DNZioo/Student_Project/(list of files, drawings)

Other design files:
Proteus/opto_transi.pdsprj
Proteus/Project Backups/opto_transi [20241220, 18-22-56].pdsprj
Proteus/Project Backups/opto_transi [20241220, 18-27-27].pdsprj
Proteus/Project Backups/opto_transi [20241223, 23-27-32].pdsprj
Proteus/Project Backups/opto_transi [20241225, 17-43-28].pdsprj
Proteus/Project Backups/opto_transi [20241228, 16-23-40].pdsprj
Proteus/Project Backups/opto_transi [20250120, 23-39-29].pdsprj
Proteus/Project Backups/opto_transi [20250121, 11-37-40].pdsprj
Proteus/Project Backups/opto_transi [20250122, 00-04-37].pdsprj
Proteus/Project Backups/opto_transi [20250206, 10-13-02].pdsprj
Proteus/Project Backups/opto_transi [20250207, 17-20-12].pdsprj
