DNZioo/Student_Project/Kicad/IOT_development_board/IOT_development_board.kicad_pcb

## KiCad design Kicad/IOT_development_board/IOT_development_board.kicad_pcb (2025-03-19)

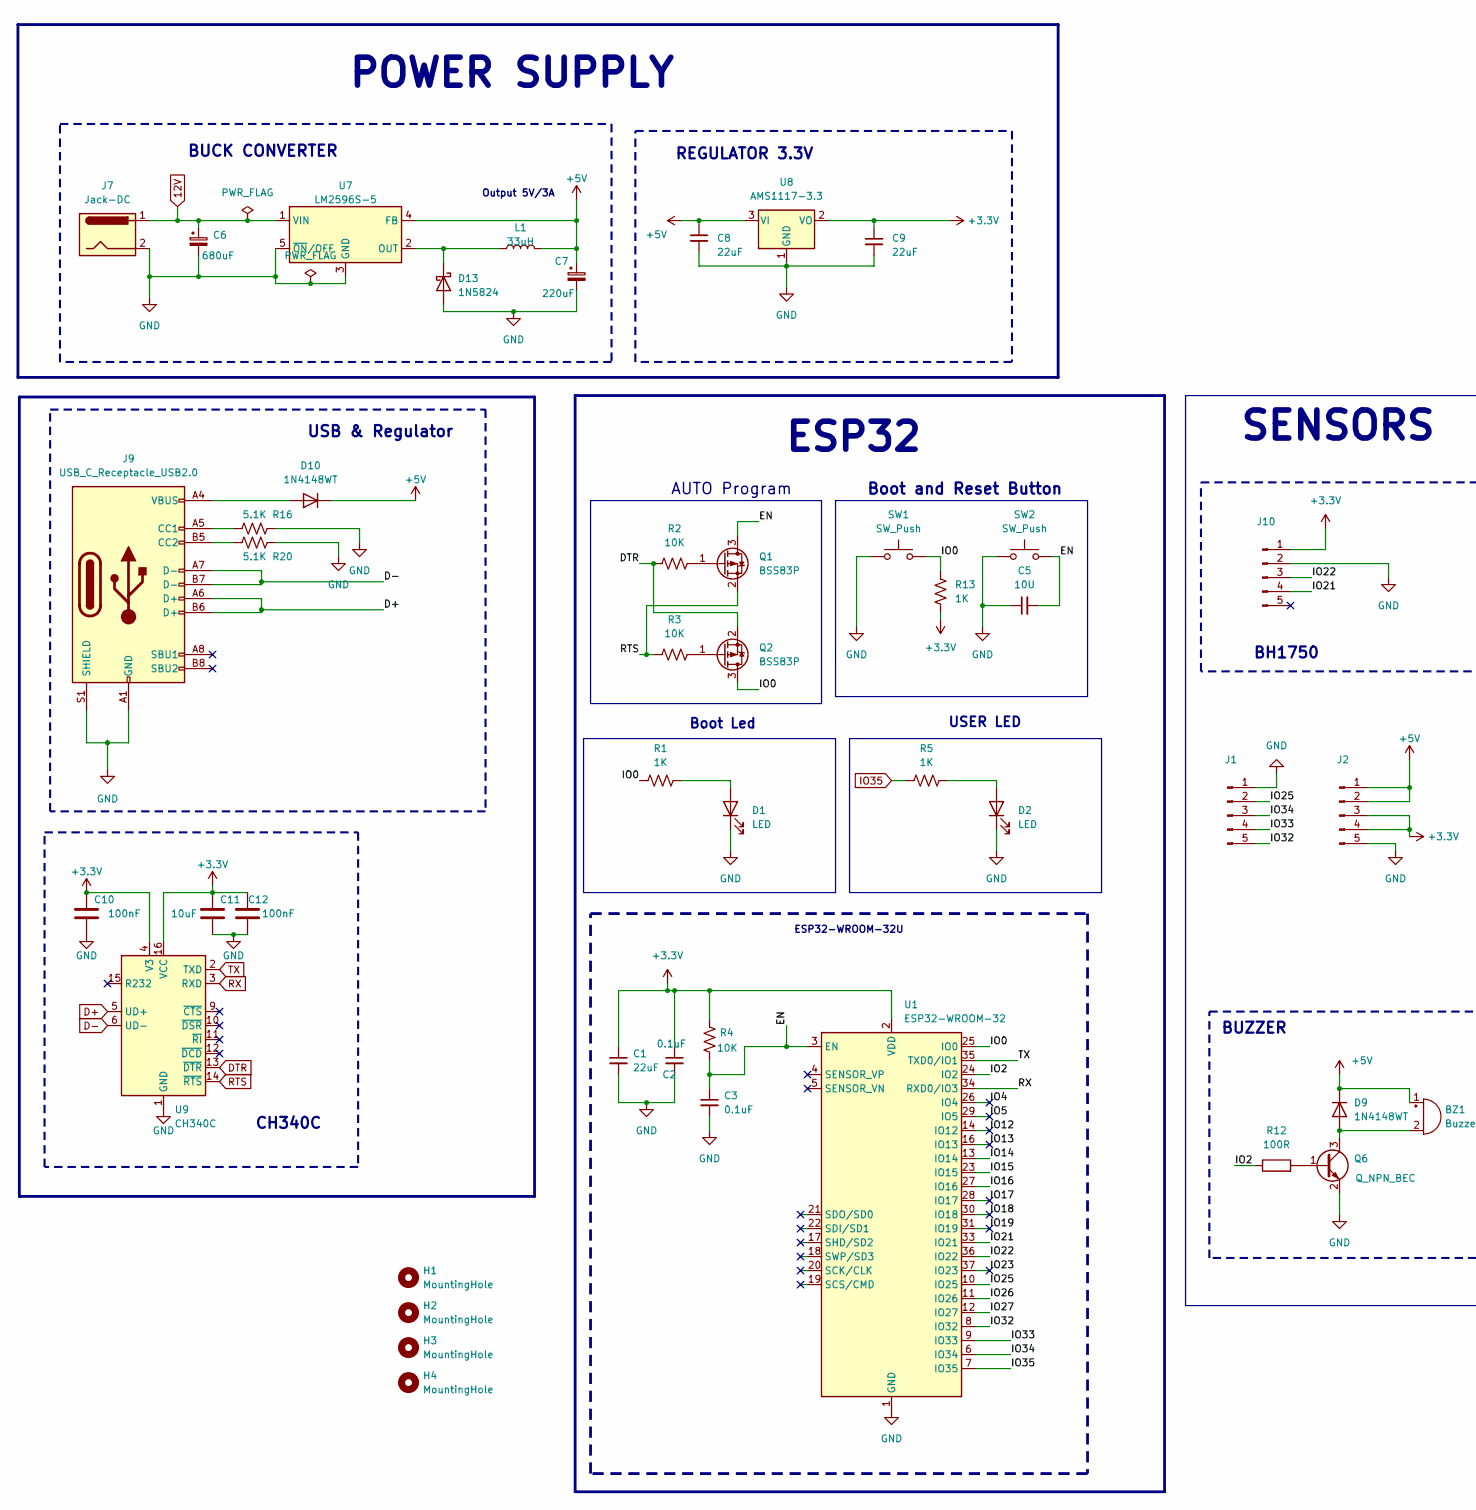
[picture p64: schematic IOT_development_board.kicad_sch, part in row 1, column 1]

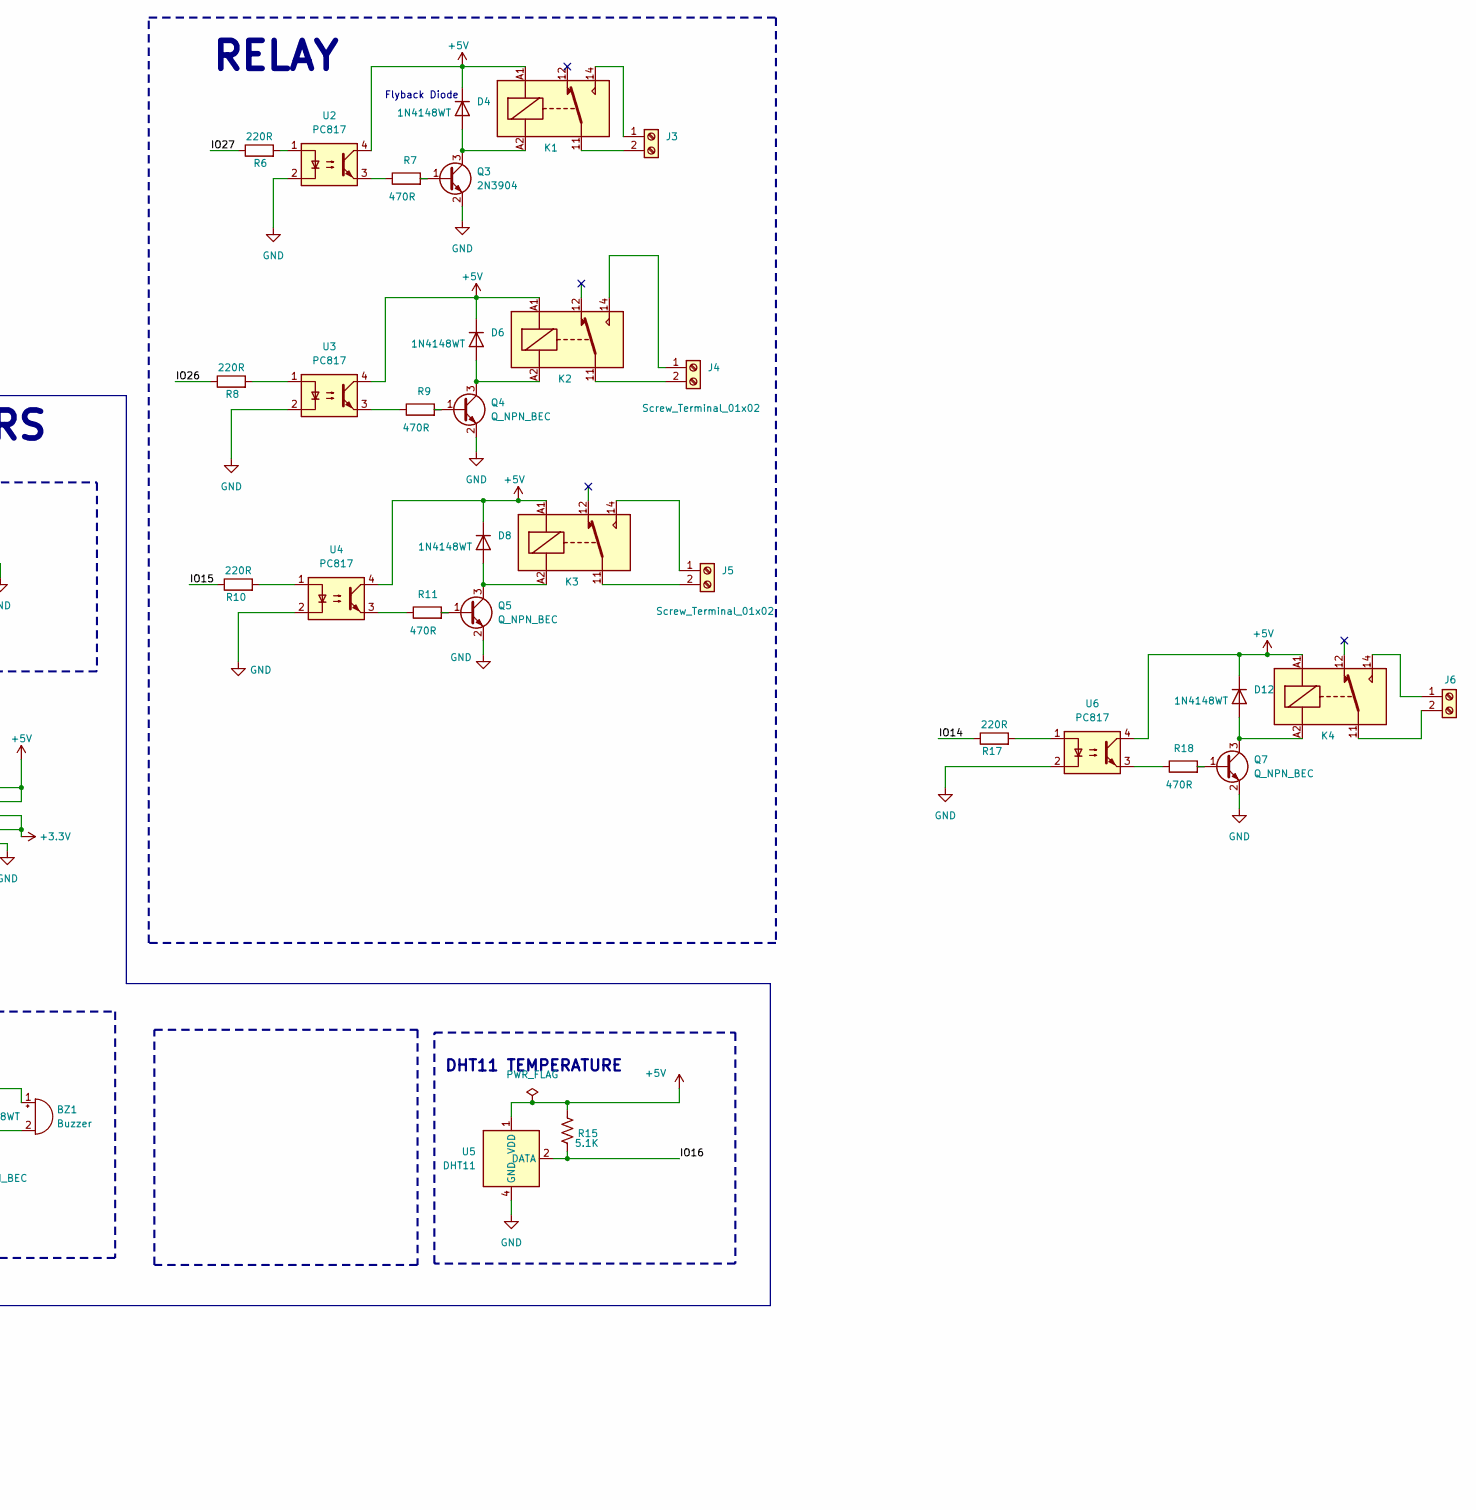
[picture p65: schematic IOT_development_board.kicad_sch, part in row 1, column 2]

Parts:
BZ1: Buzzer; Buzzer_TDK_PS1240P02BT_D12.2mm_H6.5mm
C1, C8, C9: 22uF; C_0603_1608Metric
C2, C3: 0.1uF; C_0603_1608Metric
C5: 10U; C_0603_1608Metric
C6: 680uF; CP_Elec_6.3x9.9
C7: 220uF; CP_Elec_6.3x9.9
C10, C12: 100nF; C_0603_1608Metric
C11: 10uF; C_0603_1608Metric
D1, D2: LED; LED_0603_1608Metric
D4, D6, D8, D12: 1N4148WT; D_SOD-523
D9, D10: 1N4148WT; D_SOD-123
D13: 1N5824; D_SOD-128
H1, H2, H3, H4: MountingHole; MountingHole_3.2mm_M3_Pad_Via
J1, J2, J10: Conn_01x05_Pin; PinHeader_1x05_P2.54mm_Vertical
J3, J4, J5, J6: Screw_Terminal_01x02; TerminalBlock_Phoenix_MKDS-1,5-2-5.08_1x02_P5.08mm_Horizont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
J7: Jack-DC; BarrelJack_Horizontal
J9: USB_C_Receptacle_USB2.0; USB_C_Receptacle_HRO_TYPE-C-31-M-12
K1, K2, K3, K4: Fujitsu_FTR-LYCA005x; Relay_SPDT_SANYOU_SRD_Series_Form_C_1
L1: 33uH; L_7.3x7.3_H3.5
Q1, Q2: BSS83P; SOT-23
Q3: 2N3904; SOT-23-3
Q4, Q5, Q6, Q7: Q_NPN_BEC; SOT-23-3
R1, R5, R13: 1K; R_0603_1608Metric
R2, R3, R4: 10K; R_0603_1608Metric
R6, R8, R10, R17: 220R; R_0603_1608Metric
R7, R9, R11, R18: 470R; R_0603_1608Metric
R12: 100R; R_0603_1608Metric
R15, R16, R20: 5.1K; R_0603_1608Metric
SW1, SW2: SW_Push; SW_SPST_B3U-1000P
U1: ESP32-WROOM-32
U2, U3, U4, U6: PC817
U5: DHT11; Aosong_DHT11_5.5x12.0_P2.54mm
U7: LM2596S-5; TO-263-5_TabPin3
U8: AMS1117-3.3; SOT-89-3
U9: CH340C; SOIC-16_3.9x9.9mm_P1.27mm

Connections:
12V: C6.1, J7.1, U7.1 (VIN)
+3.3V: C1.1, C2.1, C9.1, C10.1, C11.1, C12.1, J2.3, J2.4, J10.1, R4.1, R13.1, U1.2 (VDD), U8.2 (VO), U9.4 (V3), U9.16 (VCC); also elsewhere on the board
+5V: BZ1.1 (+), C7.1, C8.1, D4.1 (K), D6.1 (K), D8.1 (K), D9.1 (K), D10.1 (K), D12.1 (K), J2.1, J2.2, K1.A1, K2.A1, K3.A1, K4.A1, L1.2, R15.1, U2.4, U3.4, U4.4, U5.1 (VDD), U6.4, U7.4 (FB), U8.3 (VI)
/EN: C3.1, C5.2, Q1.3 (D), R4.2, SW2.2, U1.3 (EN)
/IO0: Q2.3 (D), R1.1, R13.2, SW1.2, U1.25 (IO0)
/IO2: R12.1, U1.24 (IO2)
/IO4: U1.26 (IO4)
/IO5: U1.29 (IO5)
/IO12: U1.14 (IO12)
/IO13: U1.16 (IO13)
/IO14: R17.1, U1.13 (IO14)
/IO15: R10.1, U1.23 (IO15)
/IO16: R15.2, U1.27 (IO16), U5.2 (DATA)
/IO17: U1.28 (IO17)
/IO18: U1.30 (IO18)
/IO19: U1.31 (IO19)
/IO21: J10.4, U1.33 (IO21)
/IO22: J10.3, U1.36 (IO22)
/IO23: U1.37 (IO23)
/IO25: J1.2, U1.10 (IO25)
/IO26: R8.1, U1.11 (IO26)
/IO27: R6.1, U1.12 (IO27)
/IO32: J1.5, U1.8 (IO32)
/IO33: J1.4, U1.9 (IO33)
/IO34: J1.3, U1.6 (IO34)
D+: J9.A6 (D+), J9.B6 (D+), U9.5 (UD+)
D-: J9.A7 (D-), J9.B7 (D-), U9.6 (UD-)
DTR: Q2.2 (S), R2.1, U9.13 (~DTR)
GND: C1.2, C2.2, C3.2, C5.1, C6.2, C7.2, C8.2, C9.2, C10.2, C11.2, C12.2, D1.1 (K), D2.1 (K), D13.2 (A), J1.1, J2.5, J7.2, J9.A1 (GND), J9.A12 (GND), J9.B1 (GND), J9.B12 (GND), J9.S1 (SHIELD), J10.2, Q3.2 (E), Q4.2 (E), Q5.2 (E), Q6.2 (E), Q7.2 (E), R16.2, R20.2, SW1.1, SW2.1, U1.1 (GND), U1.15 (GND), U1.38 (GND), U1.39 (GND), U2.2, U3.2, U4.2, U5.4 (GND), U6.2, U7.3 (GND), U7.5 (~ON/OFF), U8.1 (GND), U9.1 (GND); also elsewhere on the board
IO35: R5.1, U1.7 (IO35)
unnamed: BZ1.2 (-), D9.2 (A), Q6.3 (C)
unnamed: D1.2 (A), R1.2
unnamed: D2.2 (A), R5.2
unnamed: D4.2 (A), K1.A2, Q3.3 (C)
unnamed: D6.2 (A), K2.A2, Q4.3 (C)
unnamed: D8.2 (A), K3.A2, Q5.3 (C)
unnamed: D10.2 (A), J9.A4 (VBUS), J9.A9 (VBUS), J9.B4 (VBUS), J9.B9 (VBUS)
unnamed: D12.2 (A), K4.A2, Q7.3 (C)
unnamed: D13.1 (K), L1.1, U7.2 (OUT)
unnamed: J3.1, K1.14
unnamed: J3.2, K1.11
unnamed: J4.1, K2.14
unnamed: J4.2, K2.11
unnamed: J5.1, K3.14
unnamed: J5.2, K3.11
unnamed: J6.1, K4.14
unnamed: J6.2, K4.11
unnamed: J9.A5 (CC1), R16.1
unnamed: J9.B5 (CC2), R20.1
unnamed: Q1.1 (G), R2.2
unnamed: Q2.1 (G), R3.2
unnamed: Q3.1 (B), R7.2
unnamed: Q4.1 (B), R9.2
unnamed: Q5.1 (B), R11.2
unnamed: Q6.1 (B), R12.2
unnamed: Q7.1 (B), R18.2
unnamed: R6.2, U2.1
unnamed: R7.1, U2.3
unnamed: R8.2, U3.1
unnamed: R9.1, U3.3
unnamed: R10.2, U4.1
unnamed: R11.1, U4.3
unnamed: R17.2, U6.1
unnamed: R18.1, U6.3
RTS: Q1.2 (S), R3.1, U9.14 (~RTS)
RX: U1.34 (RXD0/IO3), U9.3 (RXD)
TX: U1.35 (TXD0/IO1), U9.2 (TXD)

Notes on the sheet:
Flyback Diode
Boot and Reset Button
Output 5V/3A
BUCK CONVERTER
USB & Regulator
ESP32-WROOM-32U
RELAY
CH340C
DHT11 TEMPERATURE
AUTO Program
POWER SUPPLY
REGULATOR 3.3V
Boot Led
ESP32
BH1750
BUZZER
SENSORS
USER LED

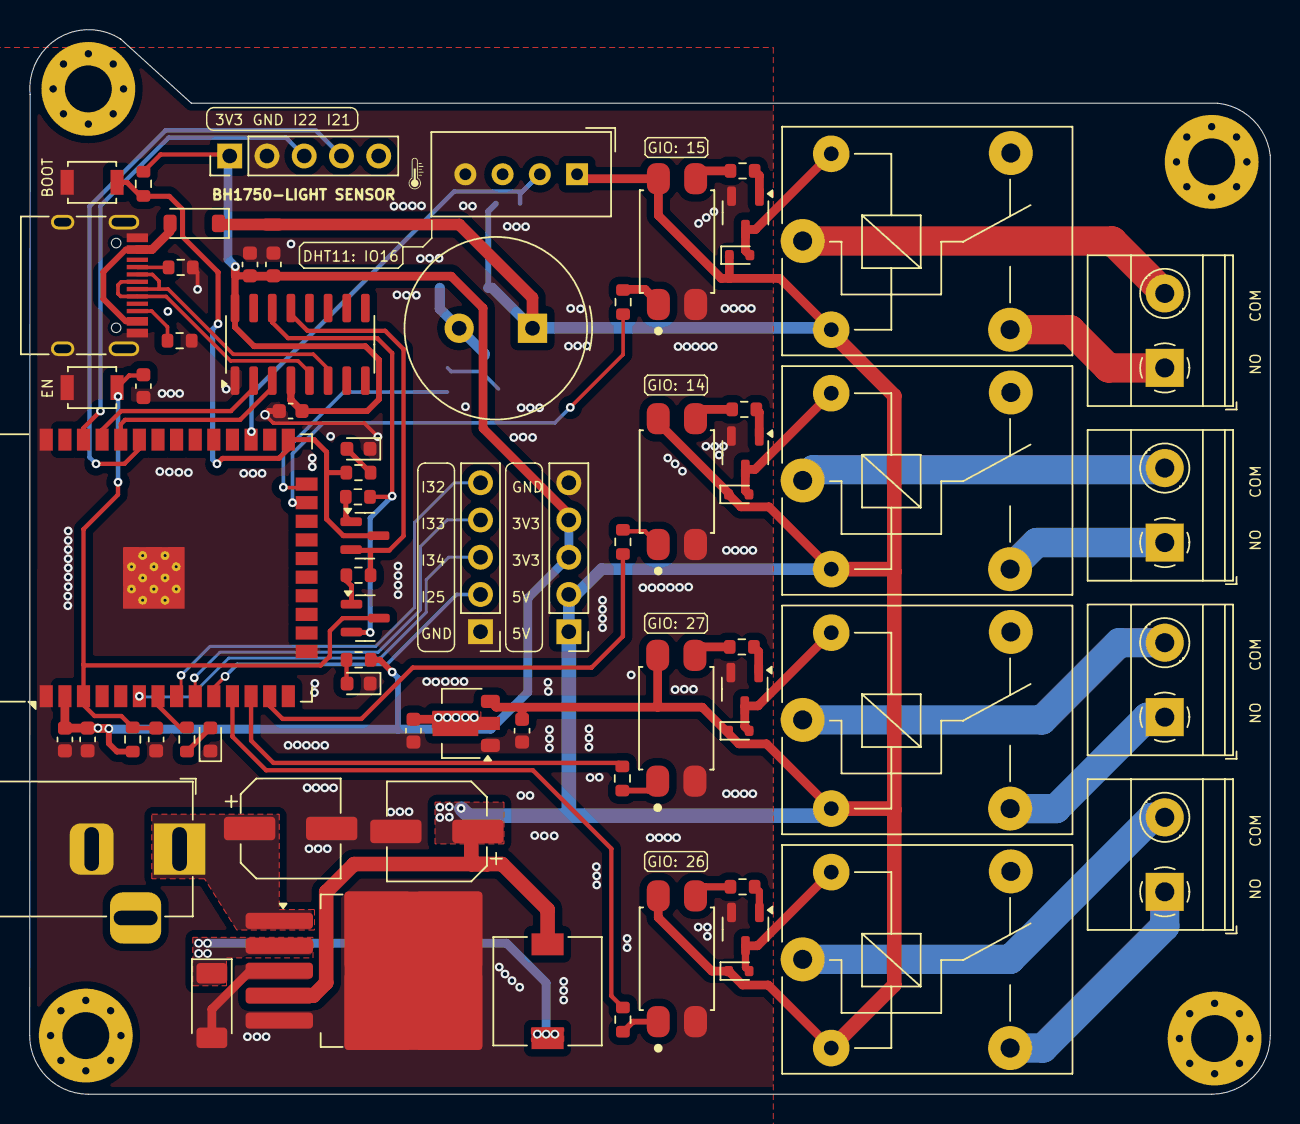
[picture p66: board IOT_development_board.kicad_pcb from above]

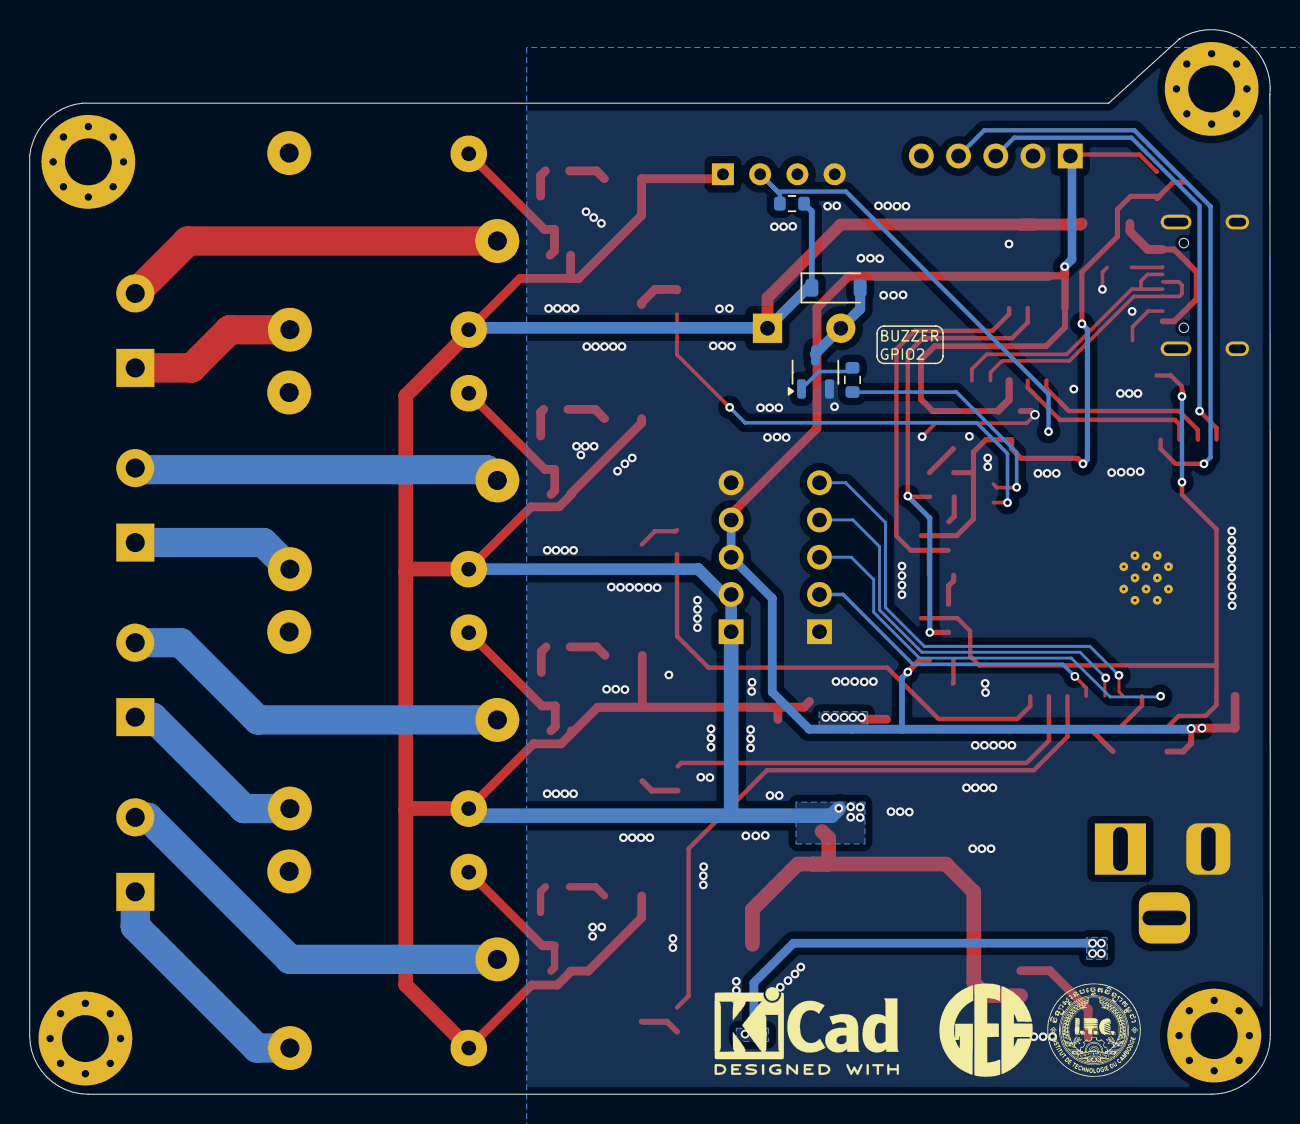
[picture p67: board IOT_development_board.kicad_pcb from below]

Board: 2 copper layers, 84.6 x 72.6 mm, 77 parts (4 on the bottom side), 60 nets.

Other parts of the board:
D14: LED; LED_0603_1608Metric
R19: 220; R_0603_1608Metric

Their connections:
+3.3V: R19.1; also elsewhere on the board
GND: D14.1 (K); also elsewhere on the board
unnamed: D14.2 (A), R19.2
