DNZioo/Student_Project/ESP_IDF/https_get_put_request/main/wifi.c

#include <stdint.h>
#include "nvs_flash.h"
#include "esp_netif.h"
#include "esp_wifi.h"
#include "esp_event.h"
#include "esp_log.h"

// Define Wi-Fi credentials
#define WIFI_SSID "MrBlack"
#define WIFI_PASS "09072023"
// Wi-Fi Event Handler Tag
static const char *TAG_WIFI = "WiFi";

// Wi-Fi Event Handler
static void wifi_event_handler(void *arg, esp_event_base_t event_base, int32_t event_id, void *event_data) {
    if (event_base == WIFI_EVENT && event_id == WIFI_EVENT_STA_START) {
        ESP_LOGI(TAG_WIFI, "Connecting to Wi-Fi...");
        esp_wifi_connect();
    } else if (event_base == WIFI_EVENT && event_id == WIFI_EVENT_STA_CONNECTED) {
        ESP_LOGI(TAG_WIFI, "Connected to Wi-Fi!");
    } else if (event_base == WIFI_EVENT && event_id == WIFI_EVENT_STA_DISCONNECTED) {
        ESP_LOGW(TAG_WIFI, "Disconnected from Wi-Fi. Retrying...");
        esp_wifi_connect();
    }
}

// Wi-Fi Initialization Function
void wifi_init() {
    esp_err_t ret = nvs_flash_init();
    if (ret == ESP_ERR_NVS_NO_FREE_PAGES || ret == ESP_ERR_NVS_NEW_VERSION_FOUND) {
        ESP_ERROR_CHECK(nvs_flash_erase());
        ret = nvs_flash_init();
    }
    ESP_ERROR_CHECK(ret);

    ESP_ERROR_CHECK(esp_netif_init());
    ESP_ERROR_CHECK(esp_event_loop_create_default());
    esp_netif_create_default_wifi_sta();

    wifi_init_config_t cfg = WIFI_INIT_CONFIG_DEFAULT();
    ESP_ERROR_CHECK(esp_wifi_init(&cfg));

    ESP_ERROR_CHECK(esp_event_handler_instance_register(
        WIFI_EVENT, ESP_EVENT_ANY_ID, &wifi_event_handler, NULL, NULL));

    wifi_config_t wifi_config = {
        .sta = {
            .ssid = WIFI_SSID,
            .password = WIFI_PASS,
        },
    };
    ESP_ERROR_CHECK(esp_wifi_set_mode(WIFI_MODE_STA));
    ESP_ERROR_CHECK(esp_wifi_set_config(WIFI_IF_STA, &wifi_config));
    ESP_ERROR_CHECK(esp_wifi_start());
}
